mattinmir/fyp/interim/main.tex

%----------------------------------------------------------------------------------------
%	PACKAGES AND OTHER DOCUMENT CONFIGURATIONS
%----------------------------------------------------------------------------------------

\documentclass[12pt]{report}
\usepackage[english]{babel}
\usepackage[utf8x]{inputenc}
\usepackage{amsmath}
\usepackage{graphicx}
\usepackage{float}
\usepackage[table,xcdraw]{xcolor}
\usepackage[colorinlistoftodos]{todonotes}
\usepackage{cite}
\usepackage{url}
\usepackage[margin=1in]{geometry}
\usepackage{booktabs}
\usepackage{dirtytalk}

\begin{document}

\begin{titlepage}

\newcommand{\HRule}{\rule{\linewidth}{0.5mm}} % Defines a new command for the horizontal lines, change thickness here

\center % Center everything on the page

%%	HEADING SECTIONS  %%

\textsc{\LARGE Imperial College London}\\[1.5cm] % Name of your university/college

%%	TITLE SECTION  %%

\HRule \\[0.4cm]
{ \huge \bfseries Smart Rods (Hardware) \\ Interim Report}\\[0.4cm] % Title of your document
\HRule \\[1.5cm]

%%	AUTHOR SECTION  %%

\begin{minipage}{0.4\textwidth}
\begin{flushleft} \large
\emph{Author:}\\
Mattin \textsc{Mir-Tahmasebi} % Your name
CID: 00824754
\end{flushleft}
\end{minipage}
~
\begin{minipage}{0.4\textwidth}
\begin{flushright} \large
\emph{Supervisor:} \\
Prof. George \textsc{Constantinides} % Supervisor's Name
\end{flushright}
\end{minipage}\\[2cm]

% If you don't want a supervisor, uncomment the two lines below and remove the section above
%\Large \emph{Author:}\\
%John \textsc{Smith}\\[3cm] % Your name

%%	LOGO SECTION  %%

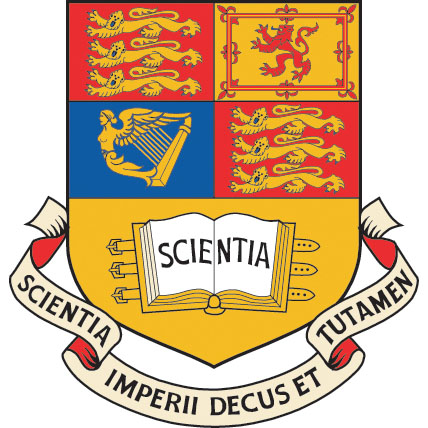
[picture p1: ImperialCrest.jpg]
\\[1cm] % Include a department/university logo - this will require the graphicx package
 
%----------------------------------------------------------------------------------------

\vfill % Fill the rest of the page with whitespace

\end{titlepage}

%% CONTENTS %%

\tableofcontents
\thispagestyle{empty}
\newpage

\pagenumbering{arabic}
\setcounter{page}{1}

%% CHAPTERS %%

\input{sections/project_specification}
\input{sections/background}
\input{sections/design_choices}
\input{sections/implementation_plan}
\input{sections/evaluation_plan}

\bibliography{references}
\bibliographystyle{ieeetr}

\end{document}
