mattinmir/fyp/interim/pics/5r.png

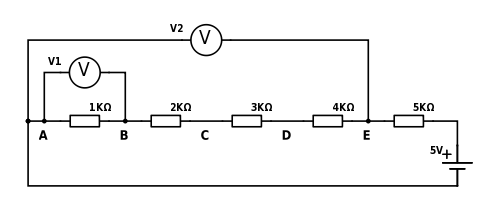
interim/pics/5r.png
