mattinmir/fyp/interim/pics/connectors.JPG

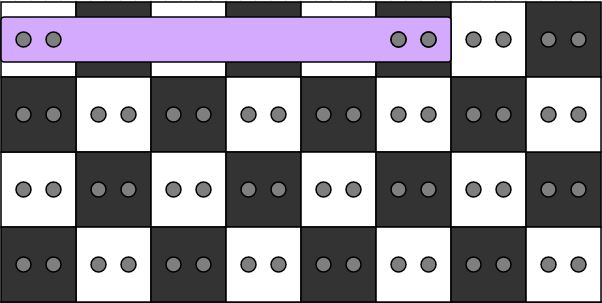
interim/pics/connectors.JPG
