mattinmir/fyp/interim/pics/doubleunitrod.png

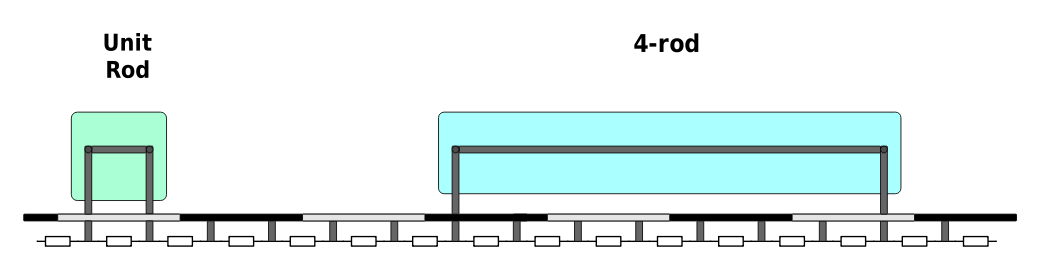
interim/pics/doubleunitrod.png
