mattinmir/fyp/interim/pics/unitrod.png

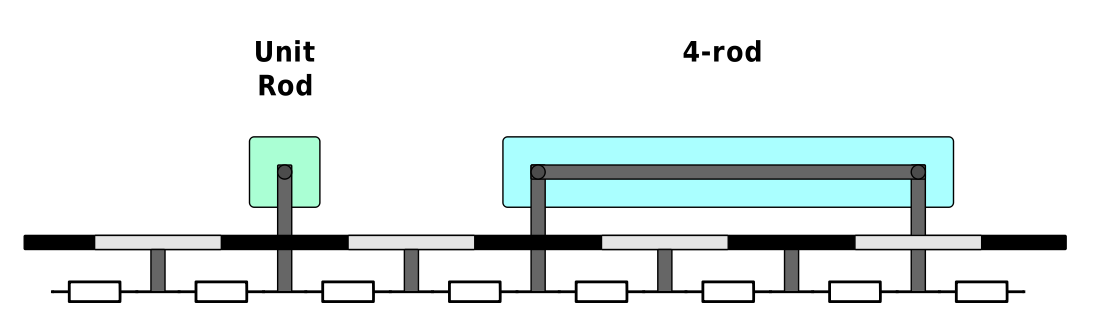
interim/pics/unitrod.png
