mattinmir/fyp/3D Printing/Failed Designs/TenRod_Conductive.stl

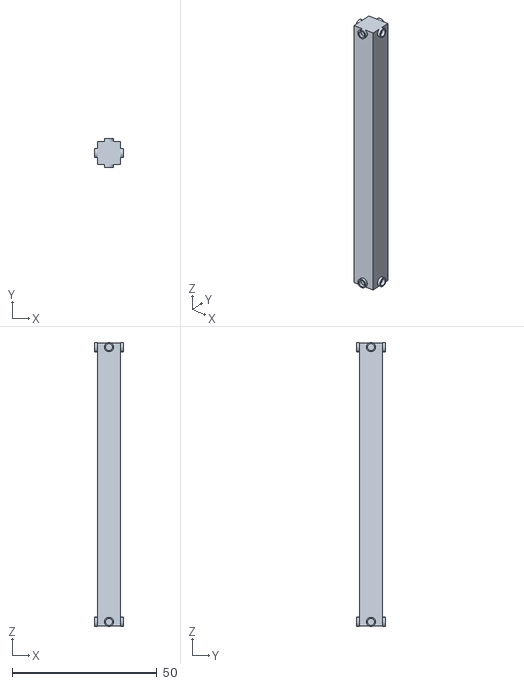
[picture p11: CAD file, 2017-05-26]
3D Printing/Failed Designs/TenRod_Conductive.stl
10.0 x 10.0 x 98.2
