mattinmir/fyp/3D Printing/filled_hole.stl

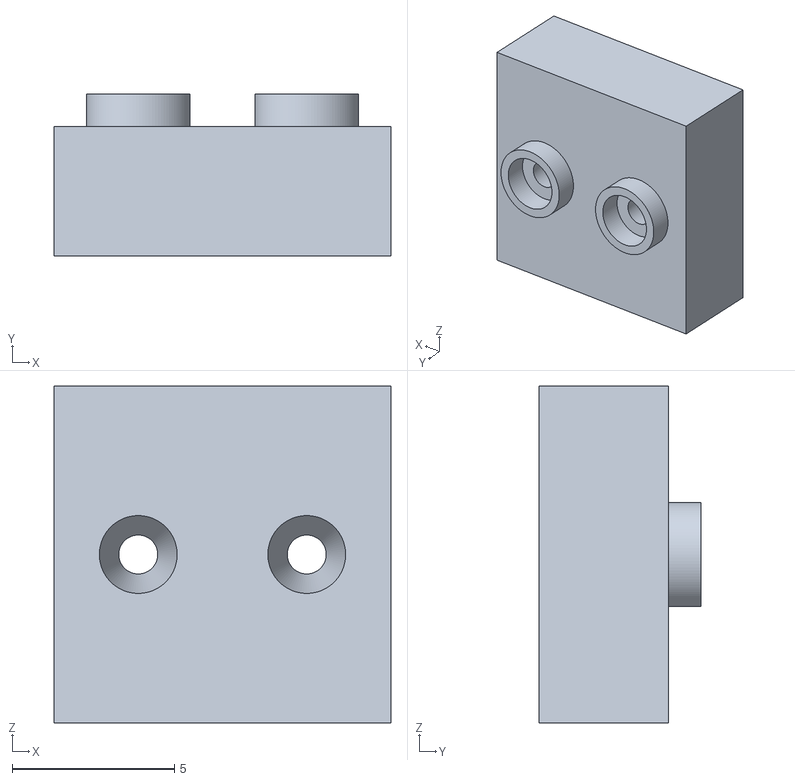
[picture p12: CAD file, 2017-06-14]
3D Printing/filled_hole.stl
10.4 x 5.00 x 10.4
