mattinmir/fyp/3D Printing/header_rods/header_8_rod v2.stl

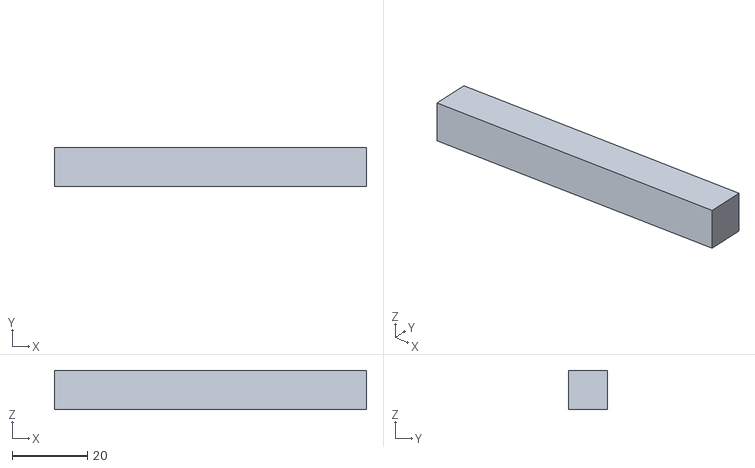
[picture p13: CAD file, 2017-06-18]
3D Printing/header_rods/header_8_rod v2.stl
83.2 x 10.4 x 10.4
