mattinmir/fyp/3D Printing/board_headers_test.stl

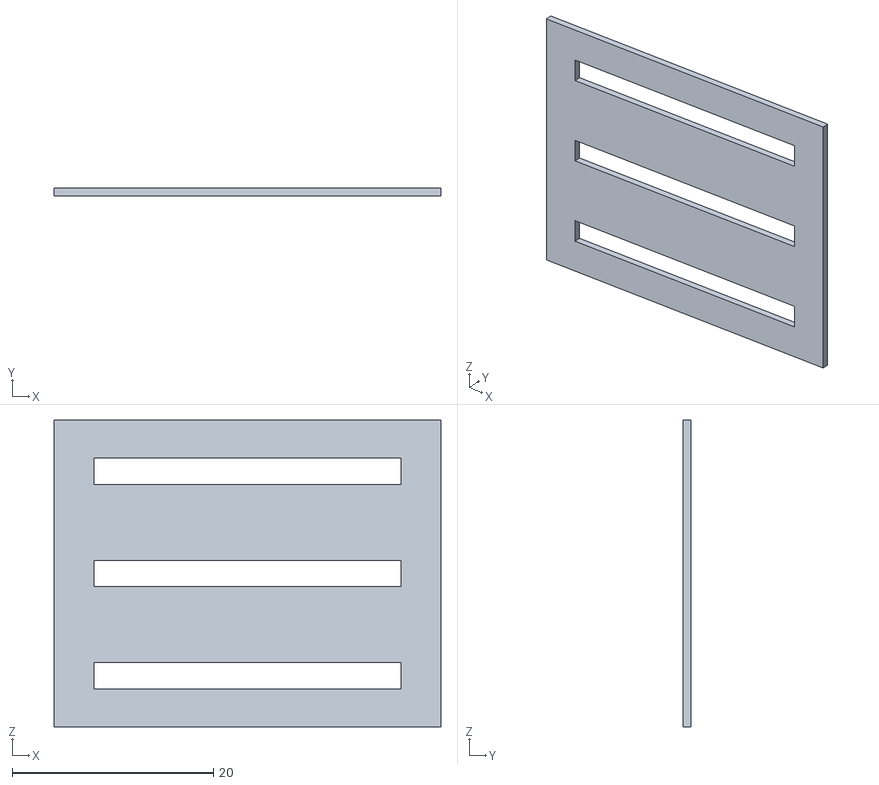
[picture p14: CAD file, 2017-06-13]
3D Printing/board_headers_test.stl
38.5 x 0.8 x 30.5
