mattinmir/fyp/3D Printing/Failed Designs/TenRod_NonConductive.stl

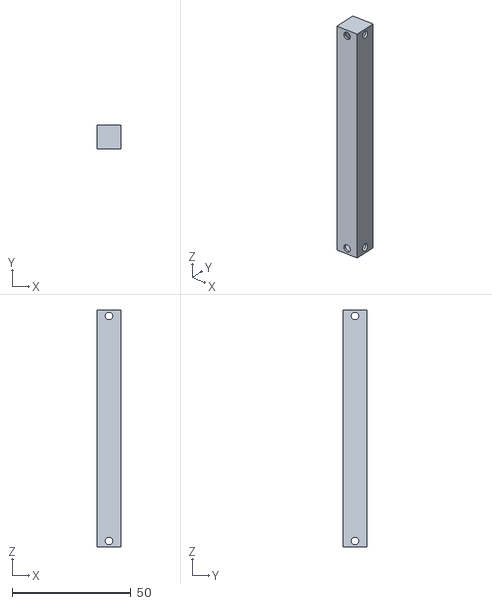
[picture p15: CAD file, 2017-05-26]
3D Printing/Failed Designs/TenRod_NonConductive.stl
10.0 x 10.0 x 100.0
