mattinmir/fyp/3D Printing/header_rods/header_4_rod v2.stl

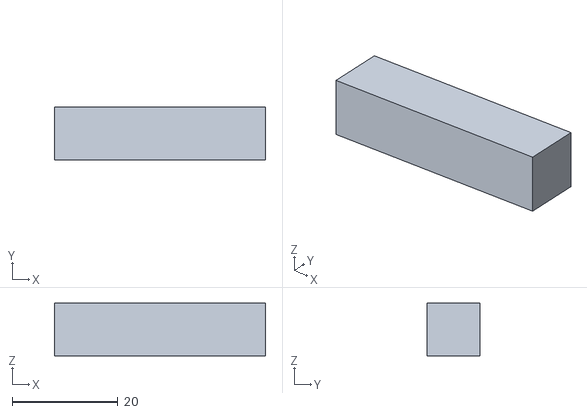
[picture p16: CAD file, 2017-06-18]
3D Printing/header_rods/header_4_rod v2.stl
40.0 x 10.0 x 10.0
