mattinmir/fyp/3D Printing/Board_Lid.stl

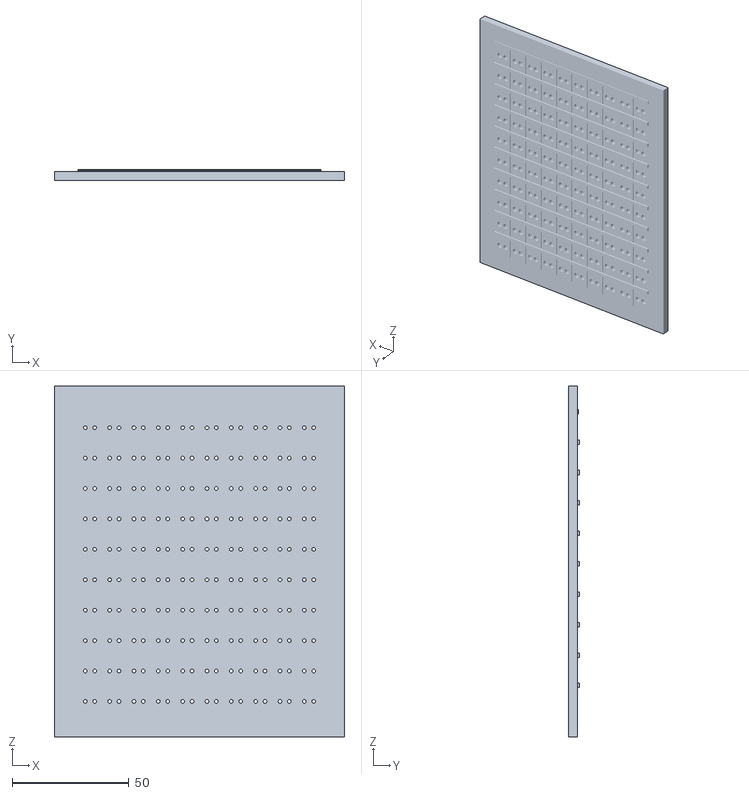
[picture p17: CAD file, 2017-06-13]
3D Printing/Board_Lid.stl
124.0 x 4.80 x 150.0
