mattinmir/fyp/3D Printing/Failed Designs/UnitRod_Conductive.stl

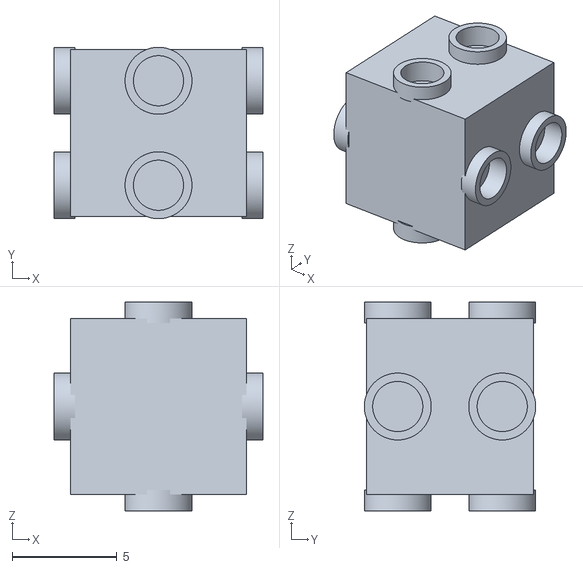
[picture p18: CAD file, 2017-05-26]
3D Printing/Failed Designs/UnitRod_Conductive.stl
10.0 x 8.20 x 10.0
