mattinmir/fyp/3D Printing/header_rods/header_6_rod v2.stl

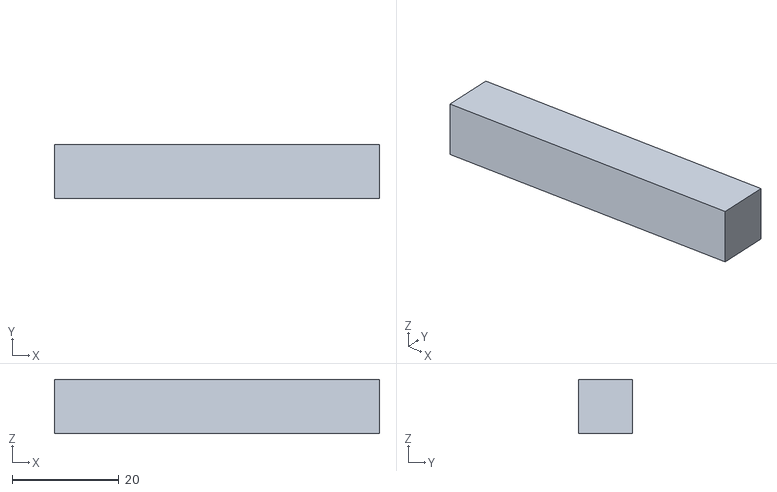
[picture p19: CAD file, 2017-06-18]
3D Printing/header_rods/header_6_rod v2.stl
61.0 x 10.2 x 10.2
