mattinmir/fyp/3D Printing/Failed Designs/UnitRod_NonConductive.stl

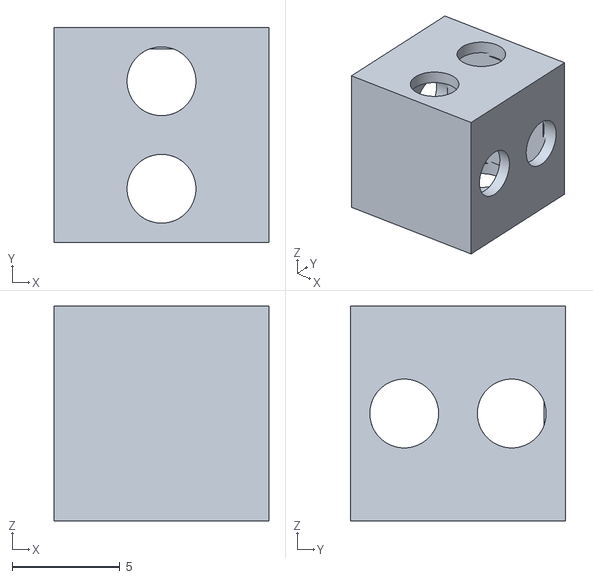
[picture p20: CAD file, 2017-05-23]
3D Printing/Failed Designs/UnitRod_NonConductive.stl
10.0 x 10.0 x 10.0
