mattinmir/fyp/3D Printing/header_rods/header_2_rod v2.stl

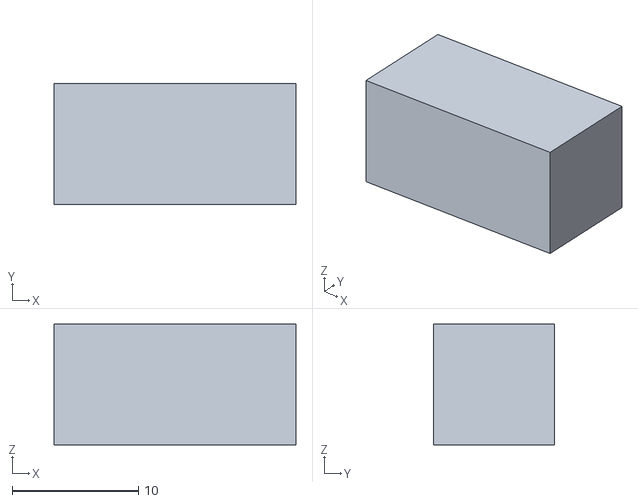
[picture p21: CAD file, 2017-06-18]
3D Printing/header_rods/header_2_rod v2.stl
19.2 x 9.60 x 9.60
