mattinmir/fyp/3D Printing/split_rod_header.stl

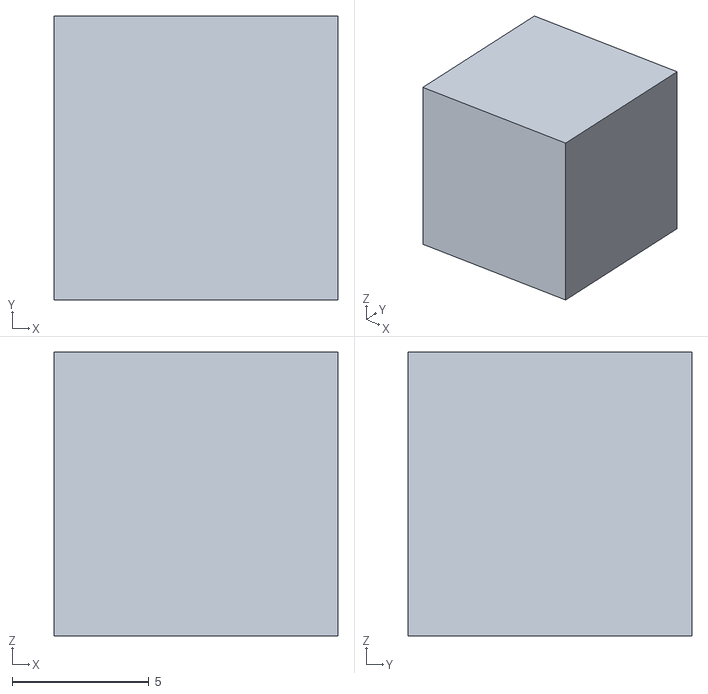
[picture p22: CAD file, 2017-06-13]
3D Printing/split_rod_header.stl
10.4 x 10.4 x 10.4
