mattinmir/fyp/3D Printing/board_lid_test.stl

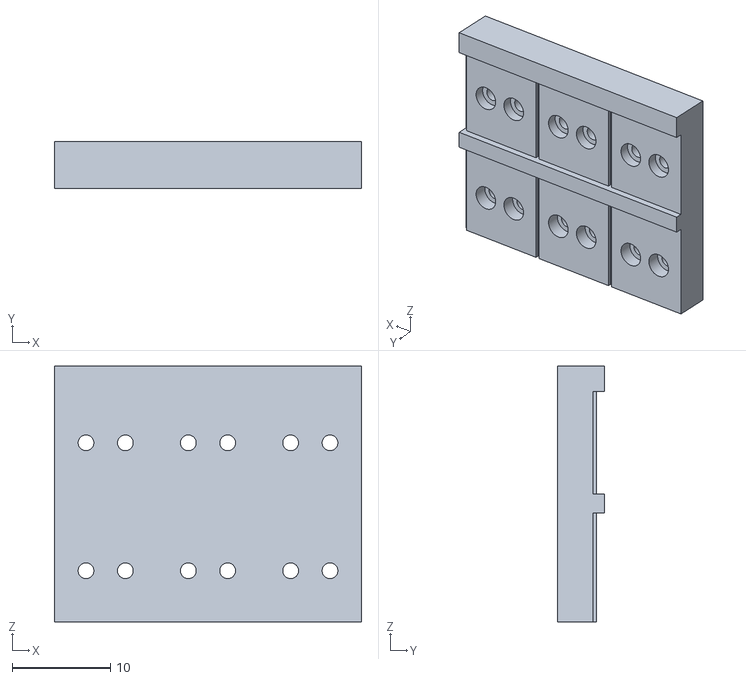
[picture p23: CAD file, 2017-06-12]
3D Printing/board_lid_test.stl
31.2 x 4.80 x 26.0
