mattinmir/fyp/3D Printing/Failed Designs/UnitRod_outer.stl

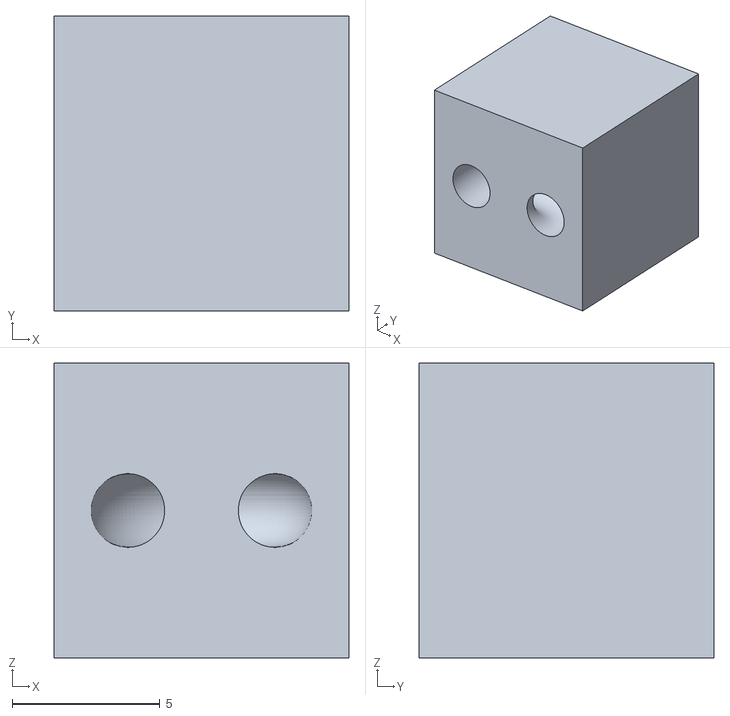
[picture p24: CAD file, 2017-05-19]
3D Printing/Failed Designs/UnitRod_outer.stl
10.0 x 10.0 x 10.0
