mattinmir/fyp/3D Printing/header_rods/header_rod v5.stl

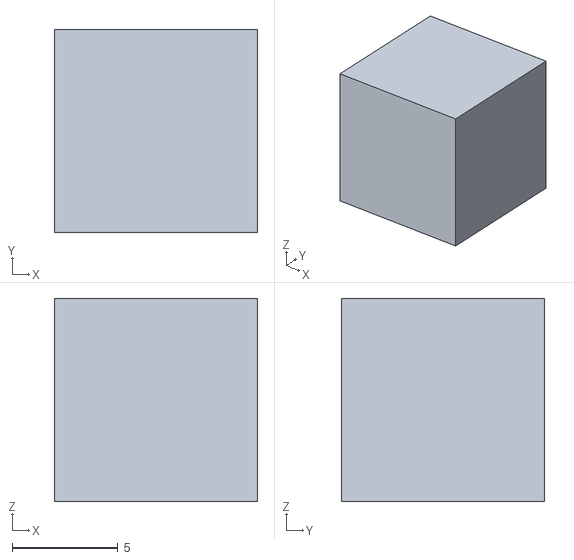
[picture p25: CAD file, 2017-06-18]
3D Printing/header_rods/header_rod v5.stl
9.60 x 9.60 x 9.60
