mattinmir/fyp/3D Printing/Failed Designs/UnitRod_inner.stl

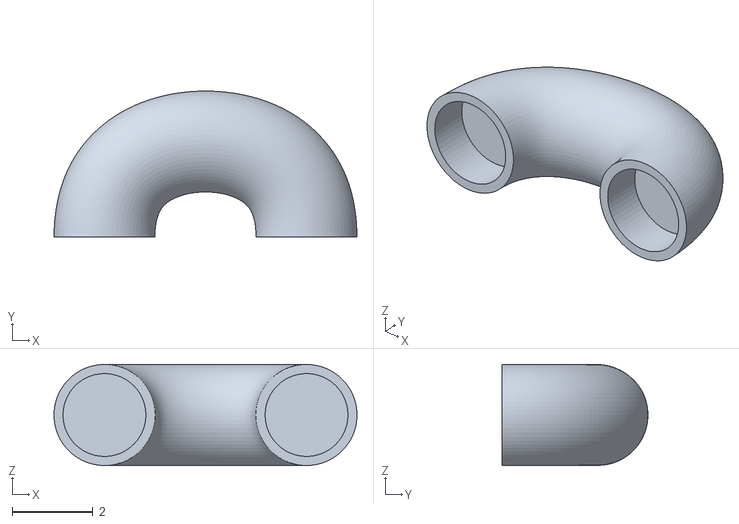
[picture p26: CAD file, 2017-05-19]
3D Printing/Failed Designs/UnitRod_inner.stl
7.50 x 3.61 x 2.50
