mattinmir/fyp/3D Printing/header_rods/header_5_rod v2.stl

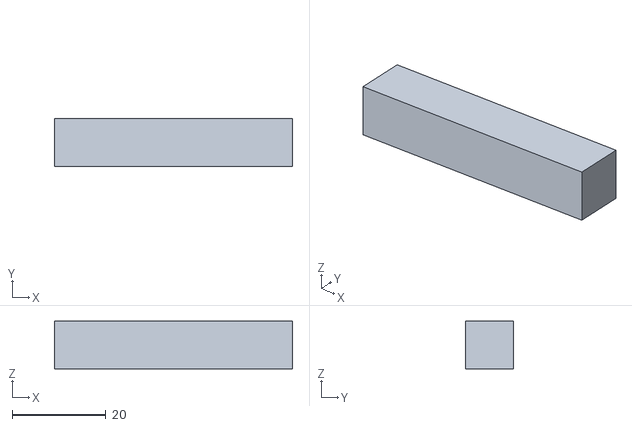
[picture p27: CAD file, 2017-06-18]
3D Printing/header_rods/header_5_rod v2.stl
50.8 x 10.2 x 10.2
