mattinmir/fyp/3D Printing/Split_Rod.stl

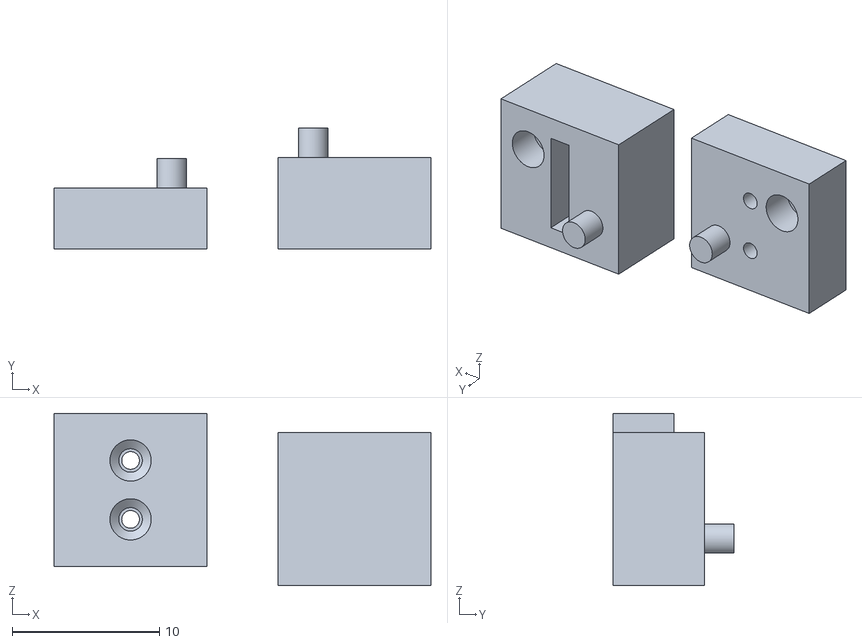
[picture p28: CAD file, 2017-06-11]
3D Printing/Split_Rod.stl
25.6 x 8.24 x 11.7
