mattinmir/fyp/3D Printing/Board_Base.stl

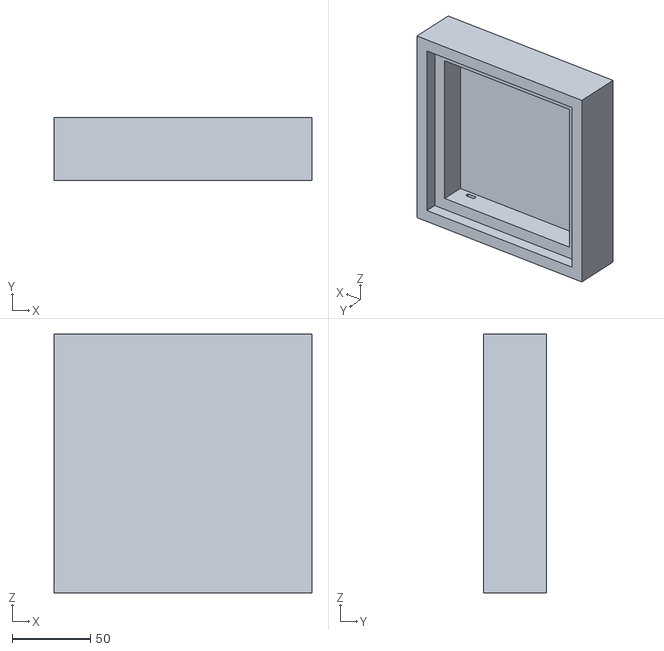
[picture p29: CAD file, 2017-05-28]
3D Printing/Board_Base.stl
165.0 x 40.0 x 165.4
