mattinmir/fyp/3D Printing/Failed Designs/Test_Rods.stl

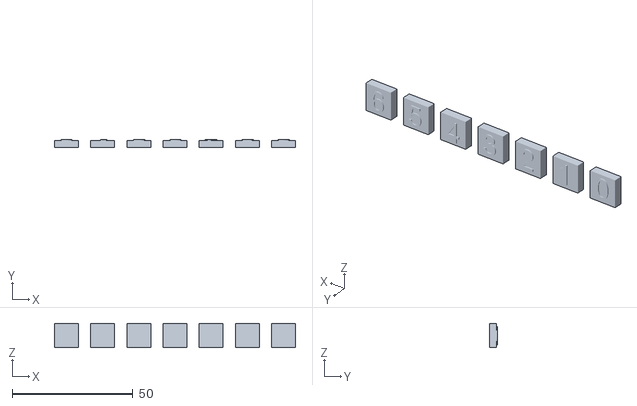
[picture p30: CAD file, 2017-05-19]
3D Printing/Failed Designs/Test_Rods.stl
100.0 x 3.50 x 10.0
