mattinmir/fyp/3D Printing/header_rods/header_3_rod v2.stl

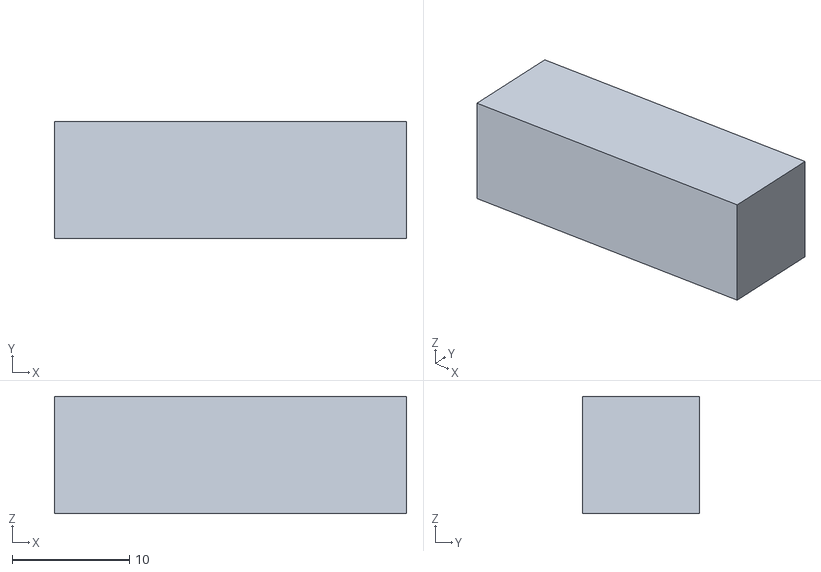
[picture p31: CAD file, 2017-06-18]
3D Printing/header_rods/header_3_rod v2.stl
30.0 x 10.0 x 10.0
