mattinmir/fyp/3D Printing/header_rods/header_7_rod v2.stl

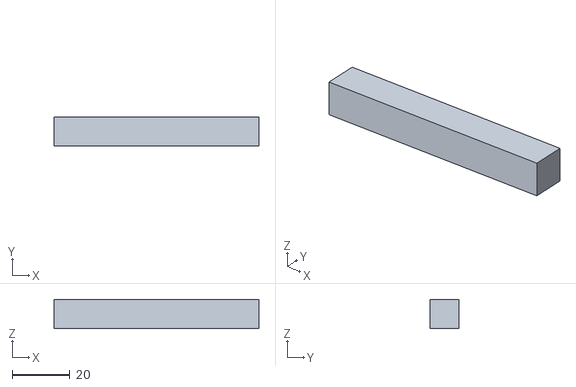
[picture p32: CAD file, 2017-06-18]
3D Printing/header_rods/header_7_rod v2.stl
71.1 x 10.2 x 10.2
