mattinmir/fyp/3D Printing/header_rods/header_9_rod v2.stl

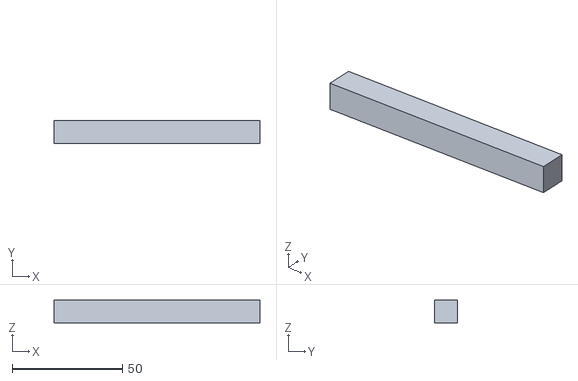
[picture p33: CAD file, 2017-06-15]
3D Printing/header_rods/header_9_rod v2.stl
93.6 x 10.4 x 10.4
