mattinmir/fyp/3D Printing/header_rods/header_10_rod v2.stl

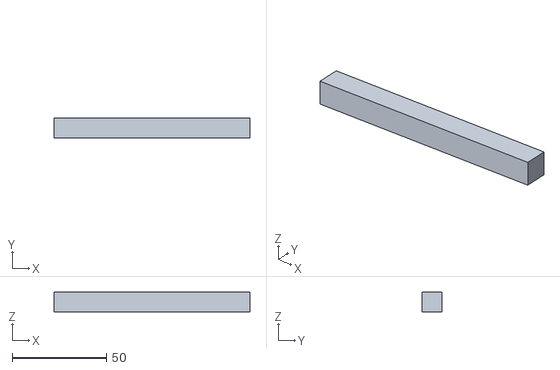
[picture p34: CAD file, 2017-06-15]
3D Printing/header_rods/header_10_rod v2.stl
104.0 x 10.4 x 10.4
