mattinmir/fyp/3D Printing/pics/board_case.png

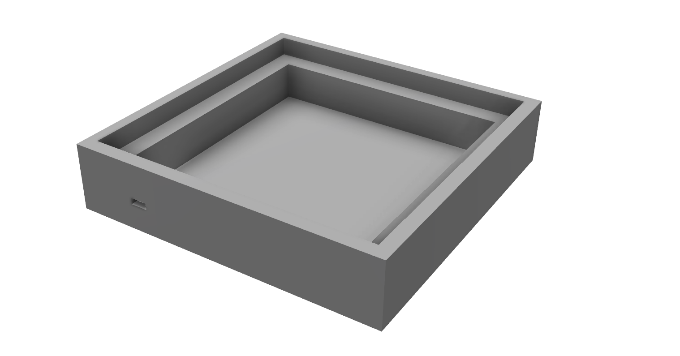
3D Printing/pics/board_case.png
