mattinmir/fyp/3D Printing/pics/boardlid.png

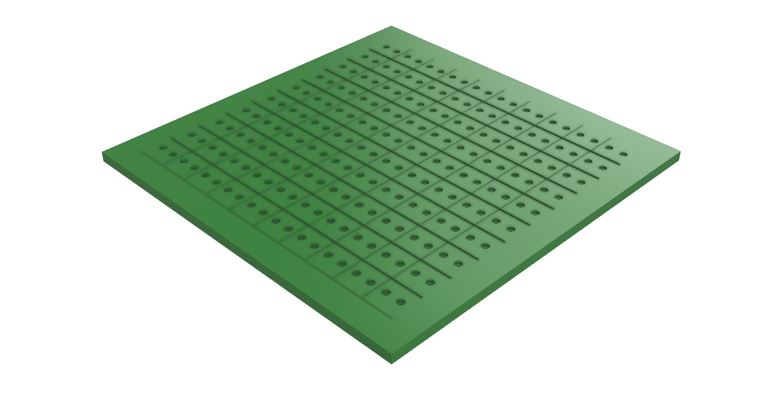
3D Printing/pics/boardlid.png
