mattinmir/fyp/3D Printing/pics/boardlid_nolines.png

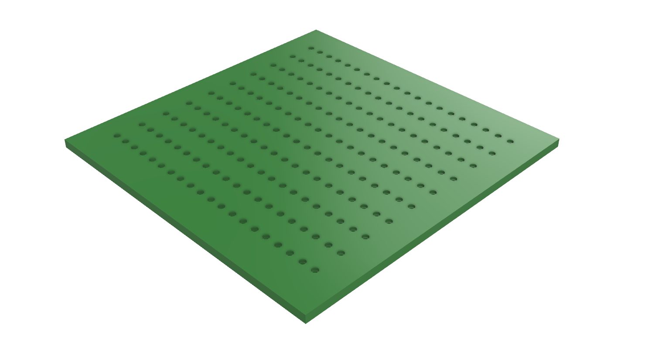
3D Printing/pics/boardlid_nolines.png
