mattinmir/fyp/3D Printing/pics/header_rod.png

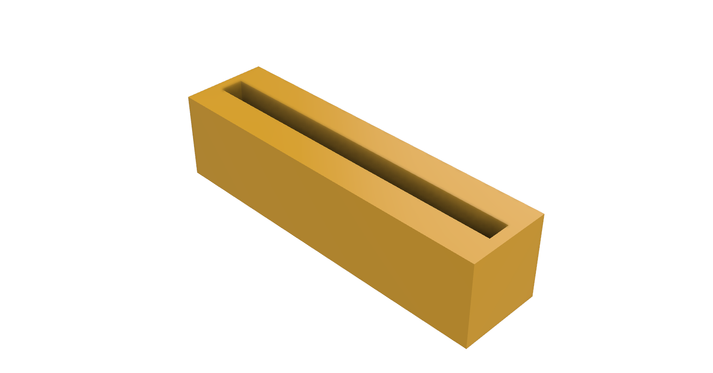
3D Printing/pics/header_rod.png
