mattinmir/fyp/3D Printing/pics/rod_cross_section_filled.png

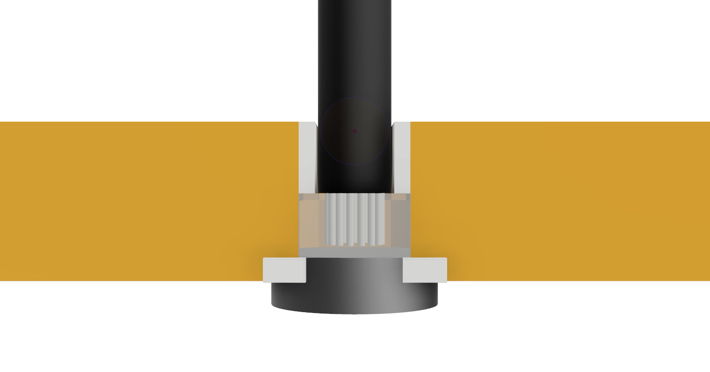
3D Printing/pics/rod_cross_section_filled.png
