mattinmir/fyp/3D Printing/pics/rod_cross_section_nofill.png

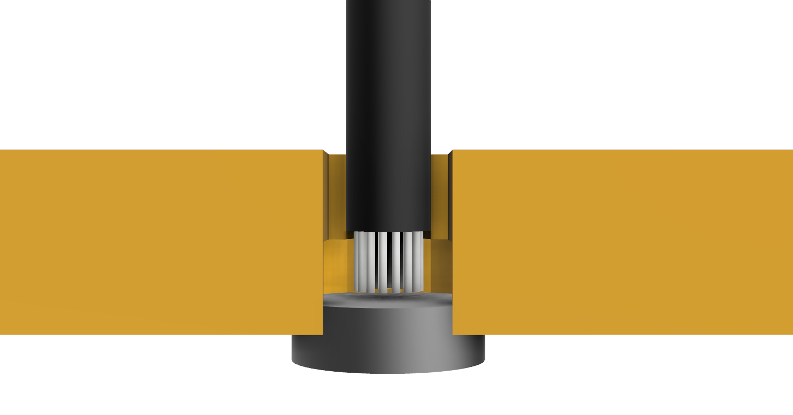
3D Printing/pics/rod_cross_section_nofill.png
