mattinmir/fyp/3D Printing/pics/splitrod_viewbottomhome.png

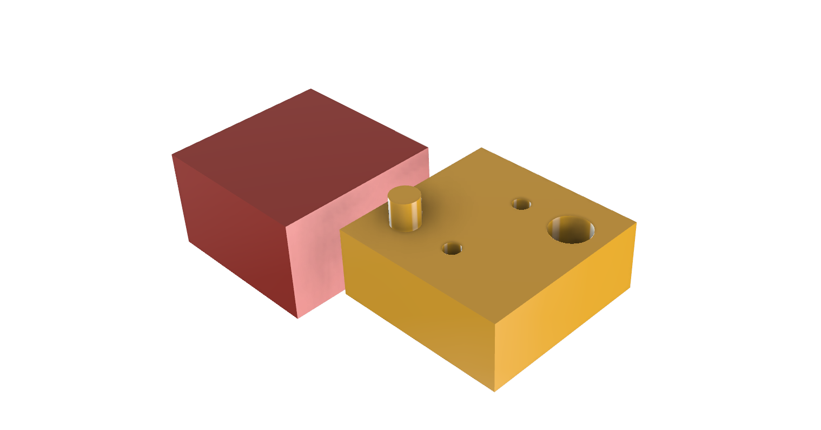
3D Printing/pics/splitrod_viewbottomhome.png
