mattinmir/fyp/3D Printing/pics/splitrod_viewhome.png

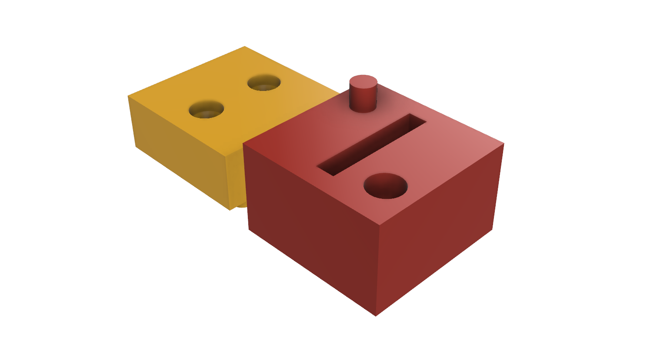
3D Printing/pics/splitrod_viewhome.png
