mattinmir/fyp/3D Printing/pics/splitrod_viewtop.png

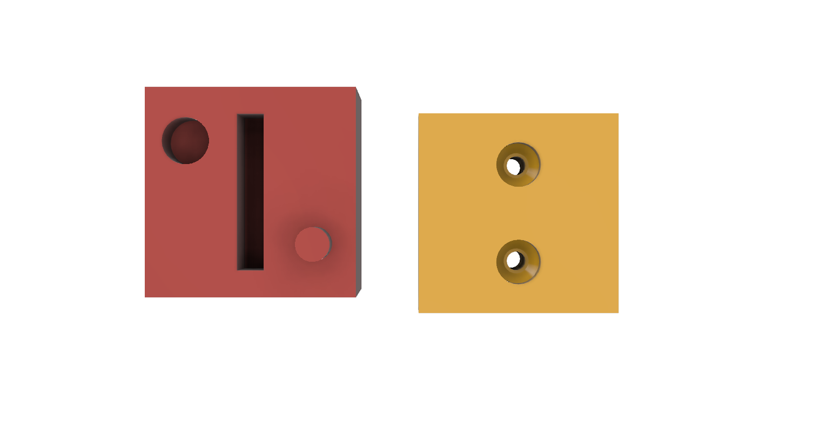
3D Printing/pics/splitrod_viewtop.png
