mattinmir/fyp/3D Printing/pics/tenrod_render.png

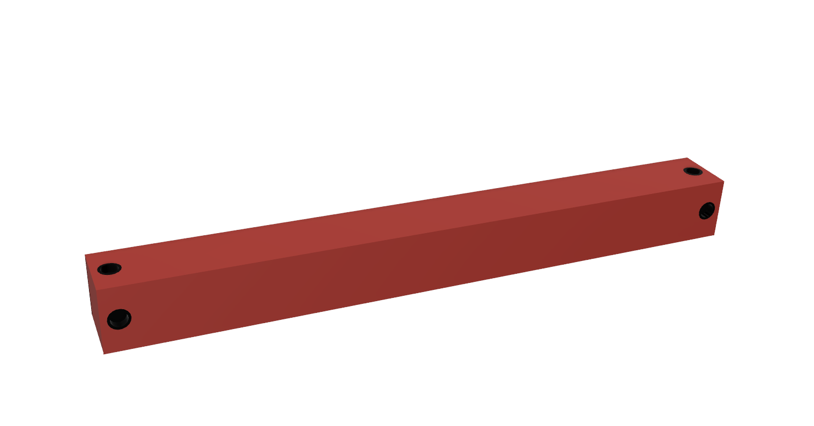
3D Printing/pics/tenrod_render.png
