mattinmir/fyp/(list of files, drawings)

Other design files:
Circuit Diagrams/Fritzing/final.fzz
Circuit Diagrams/Fritzing/stripboard.fzz
