mattinmir/fyp/Circuit Diagrams/eagle/fyp.sch

## EAGLE design Circuit Diagrams/eagle/fyp.sch (2017-05-13)

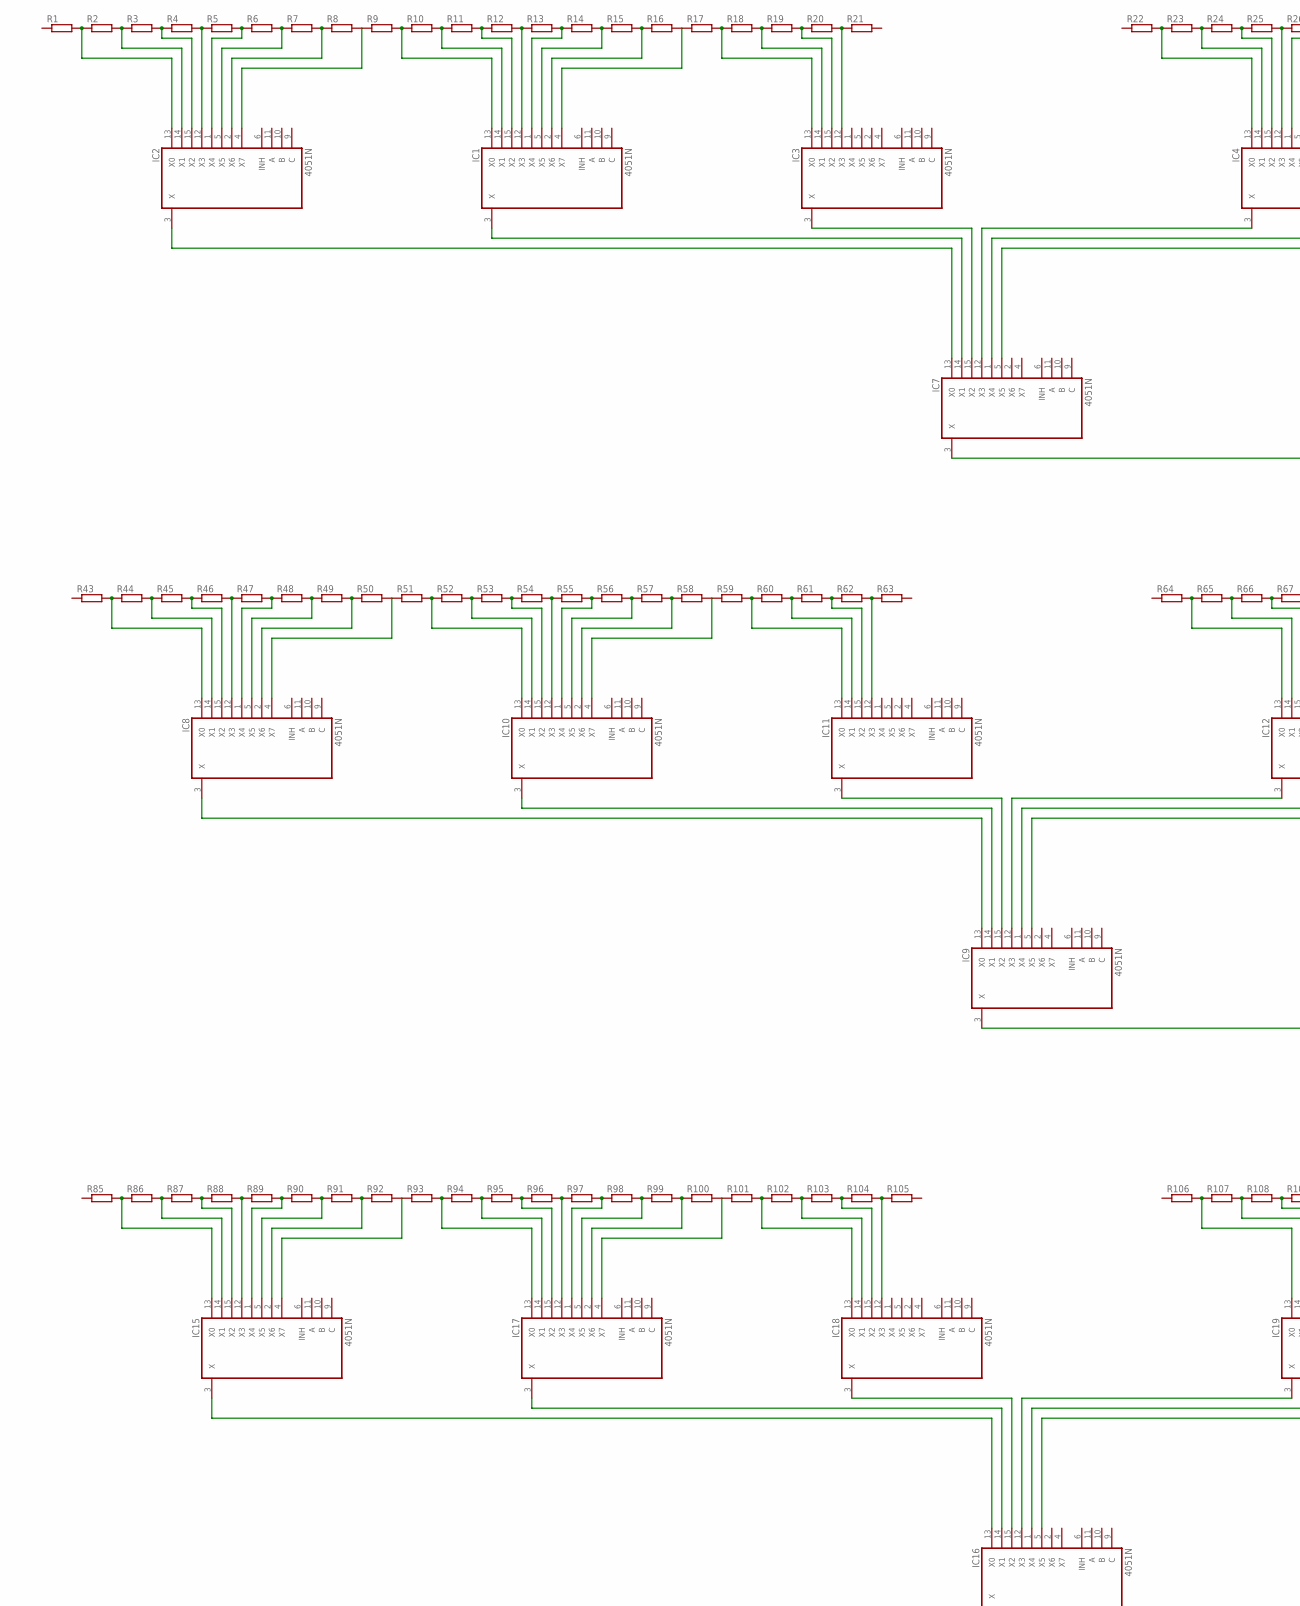
[picture p45: schematic fyp.sch, part in row 1, column 1]

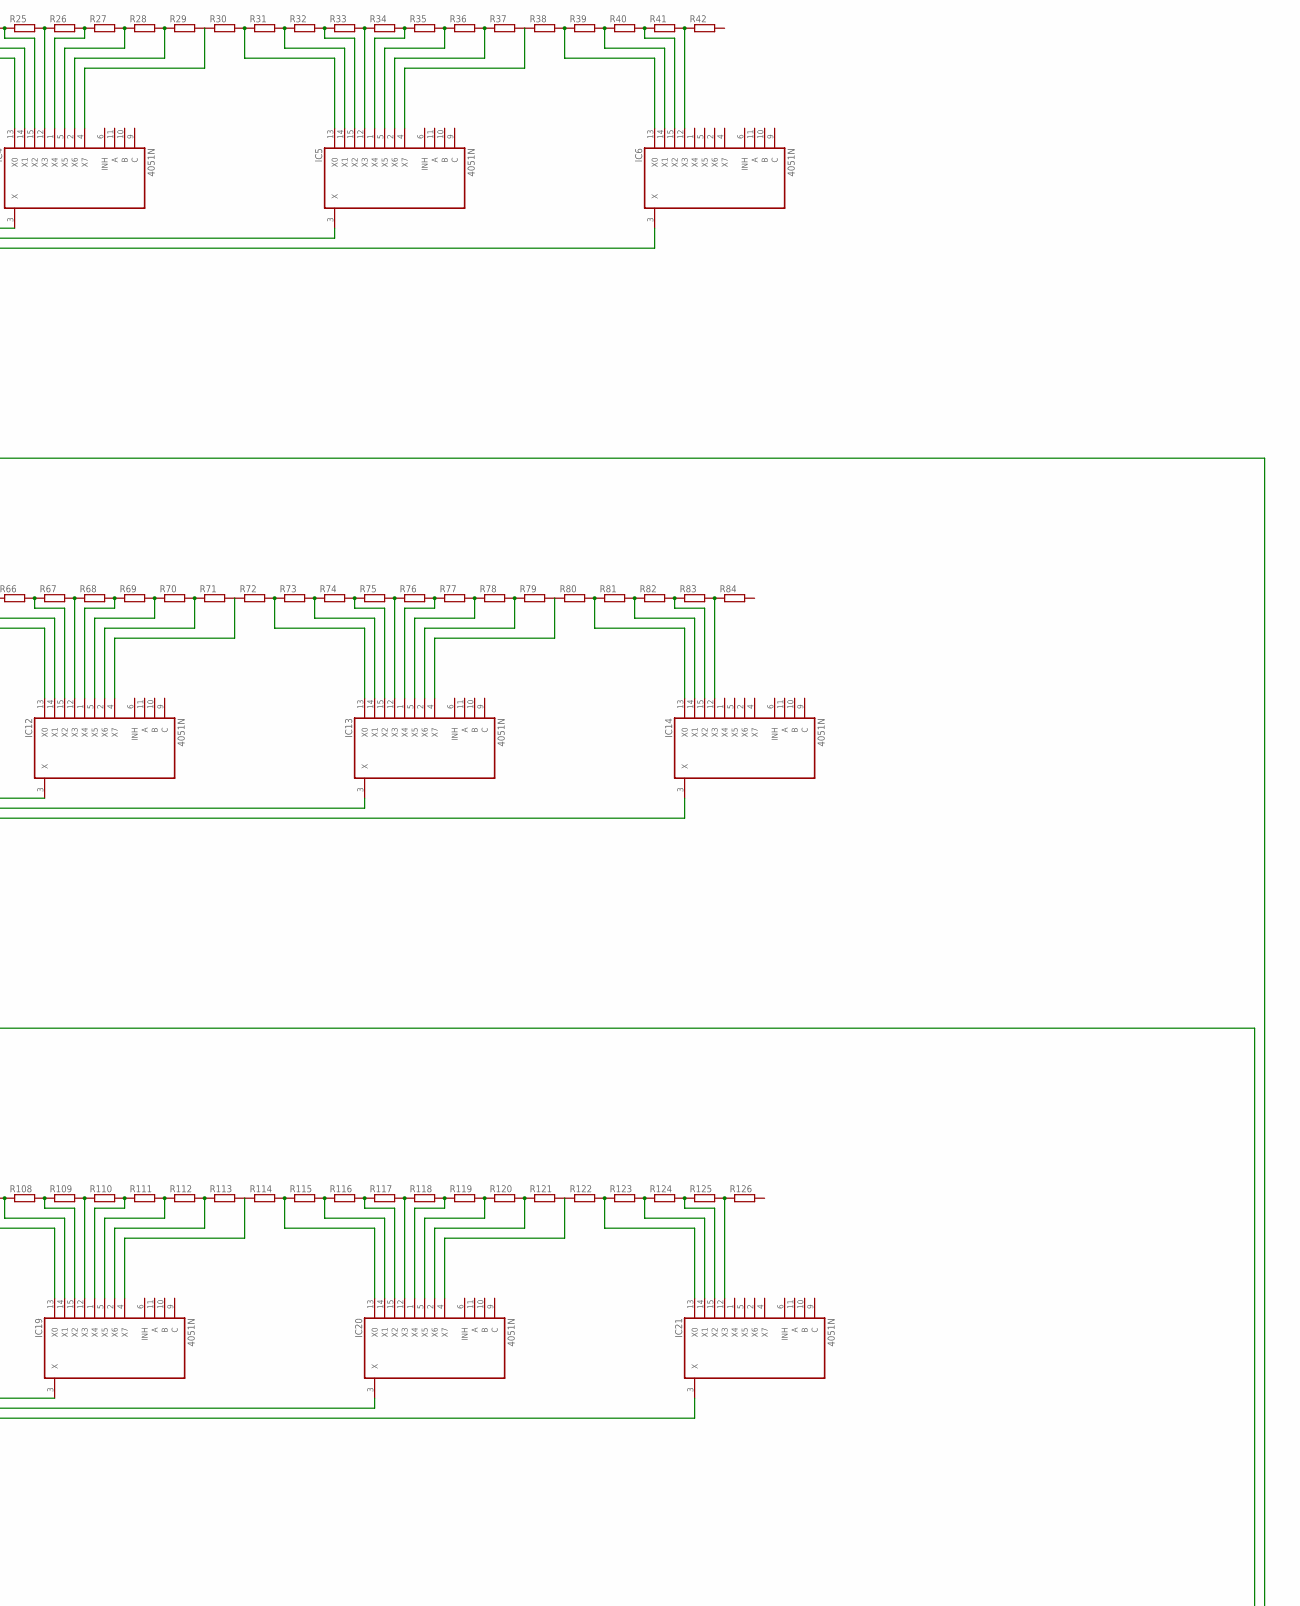
[picture p46: schematic fyp.sch, part in row 1, column 2]

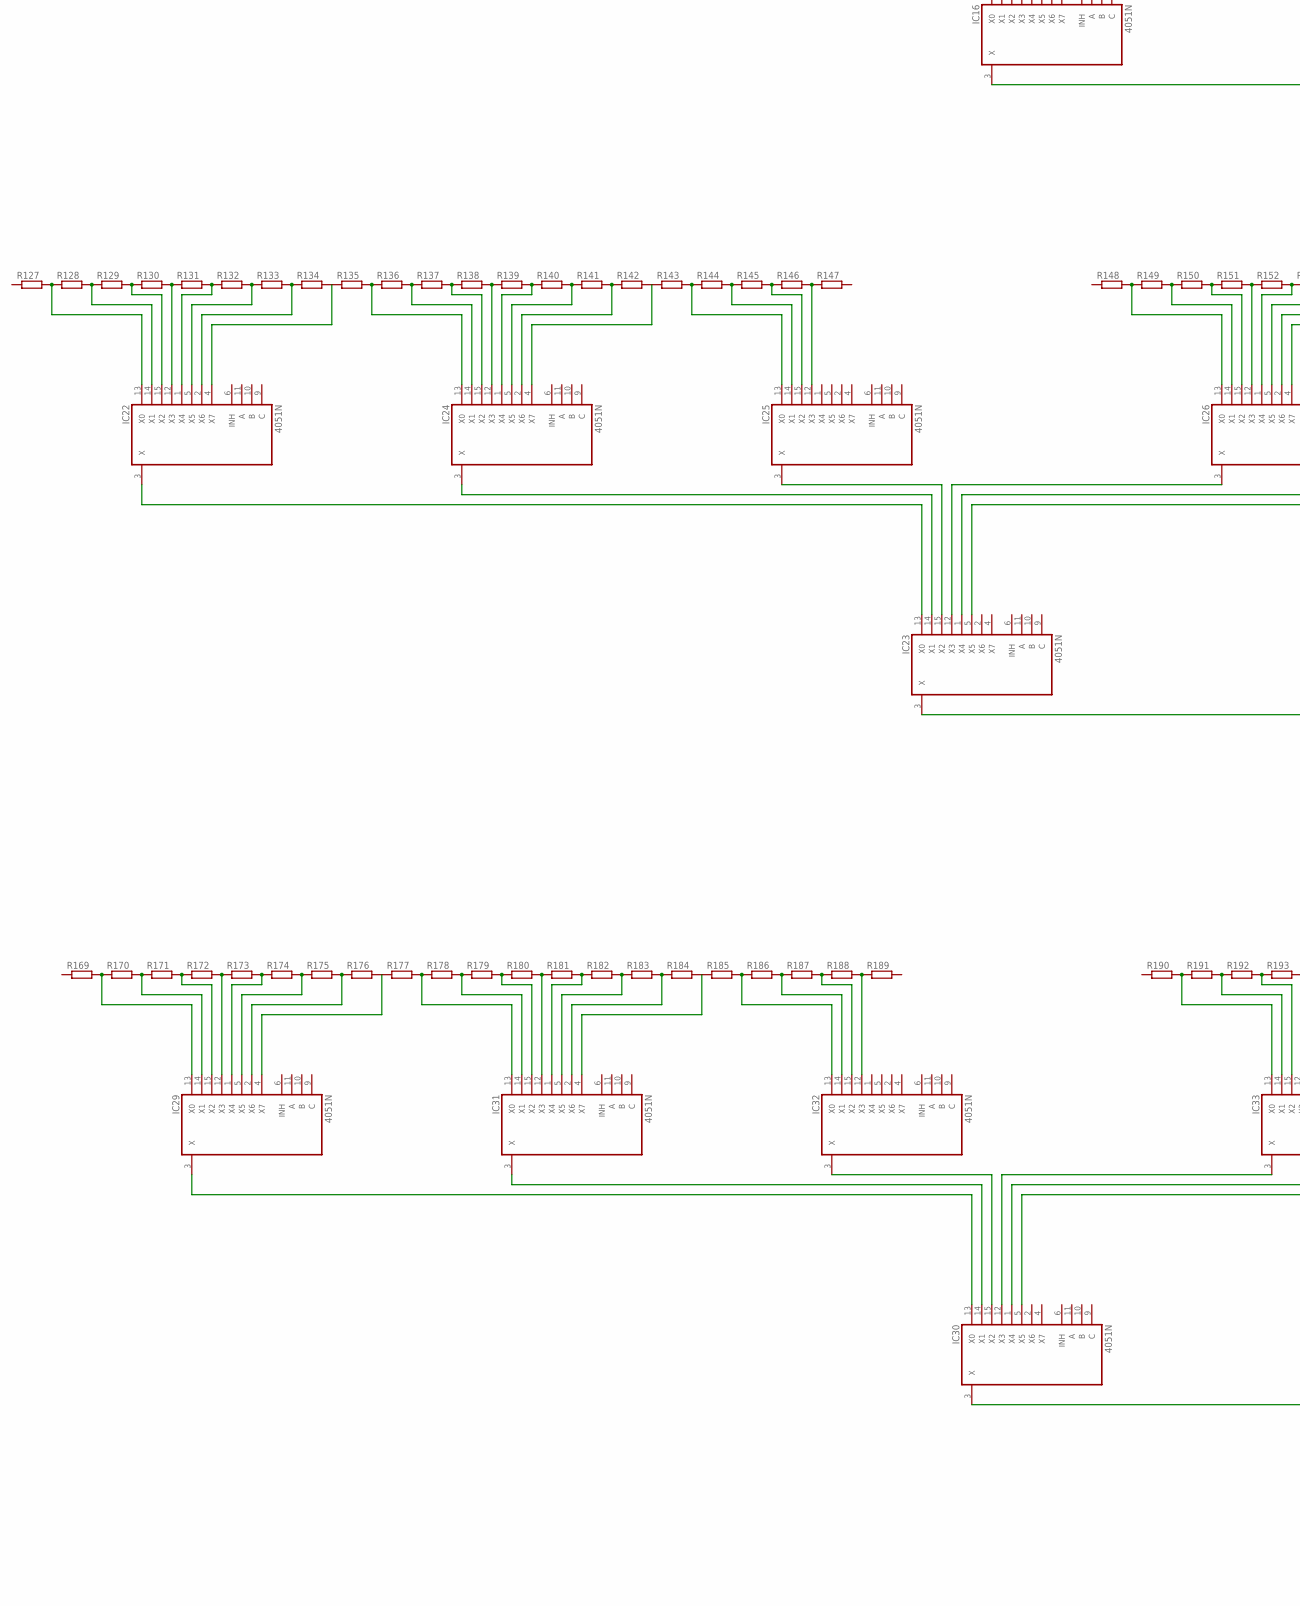
[picture p47: schematic fyp.sch, part in row 2, column 1]

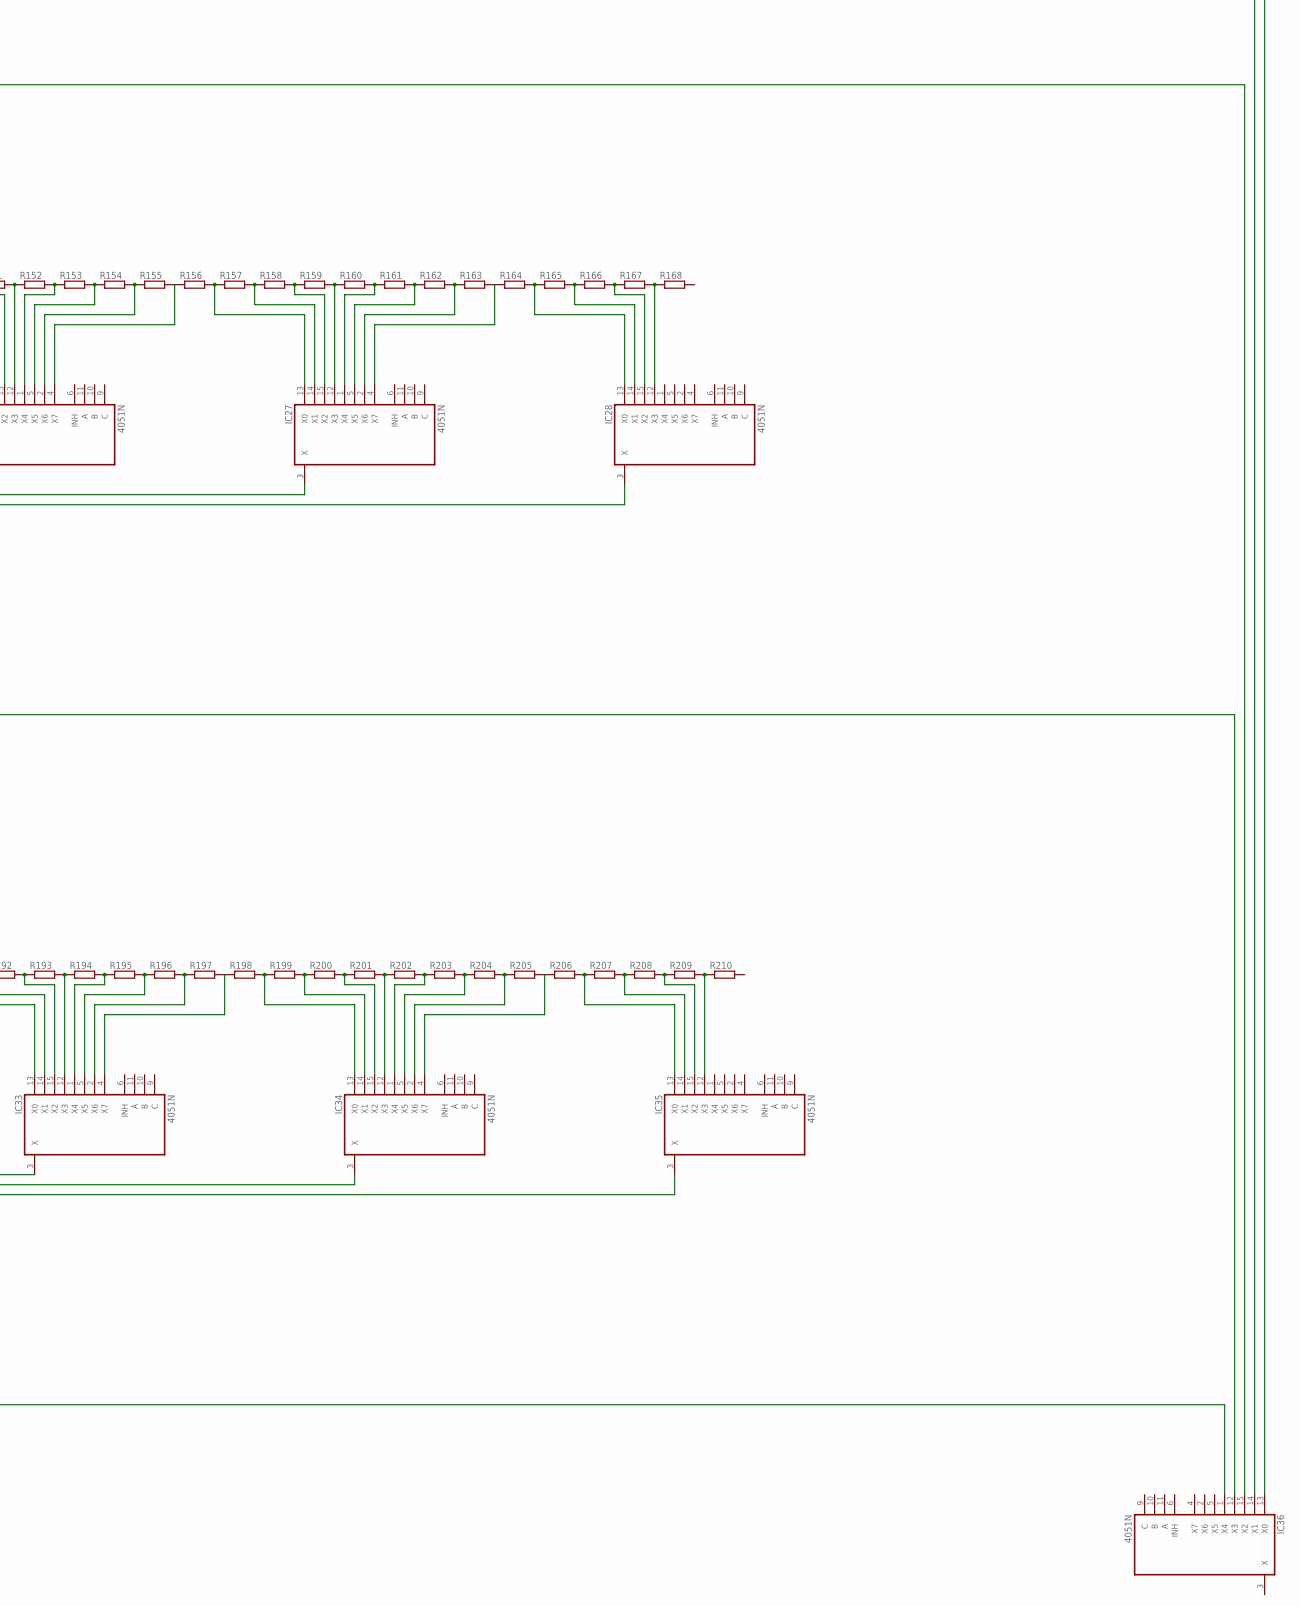
[picture p48: schematic fyp.sch, part in row 2, column 2]

Parts:
IC1, IC2, IC3, IC4, IC5, IC6, IC7, IC8, IC9, IC10, IC11, IC12, IC13, IC14, IC15, IC16, IC17, IC18, IC19, IC20, IC21, IC22, IC23, IC24, IC25, IC26, IC27, IC28, IC29, IC30, IC31, IC32, IC33, IC34, IC35, IC36: 4051N; DIL16
R1, R2, R3, R4, R5, R6, R7, R8, R9, R10, R11, R12, R13, R14, R15, R16, R17, R18, R19, R20, R21, R22, R23, R24, R25, R26, R27, R28, R29, R30, R31, R32, R33, R34, R35, R36, R37, R38, R39, R40, R41, R42, R43, R44, R45, R46, R47, R48, R49, R50, R51, R52, R53, R54, R55, R56, R57, R58, R59, R60, R61, R62, R63, R64, R65, R66, R67, R68, R69, R70, R71, R72, R73, R74, R75, R76, R77, R78, R79, R80, R81, R82, R83, R84, R85, R86, R87, R88, R89, R90, R91, R92, R93, R94, R95, R96, R97, R98, R99, R100, R101, R102, R103, R104, R105, R106, R107, R108, R109, R110, R111, R112, R113, R114, R115, R116, R117, R118, R119, R120, R121, R122, R123, R124, R125, R126, R127, R128, R129, R130, R131, R132, R133, R134, R135, R136, R137, R138, R139, R140, R141, R142, R143, R144, R145, R146, R147, R148, R149, R150, R151, R152, R153, R154, R155, R156, R157, R158, R159, R160, R161, R162, R163, R164, R165, R166, R167, R168, R169, R170, R171, R172, R173, R174, R175, R176, R177, R178, R179, R180, R181, R182, R183, R184, R185, R186, R187, R188, R189, R190, R191, R192, R193, R194, R195, R196, R197, R198, R199, R200, R201, R202, R203, R204, R205, R206, R207, R208, R209, R210: R-EU_0204/2V; 0204V

Connections:
unnamed: IC2.13 (X0), R1.2, R2.1
unnamed: IC2.14 (X1), R2.2, R3.1
unnamed: IC2.15 (X2), R3.2, R4.1
unnamed: IC2.12 (X3), R4.2, R5.1
unnamed: IC2.1 (X4), R5.2, R6.1
unnamed: IC2.5 (X5), R6.2, R7.1
unnamed: IC2.2 (X6), R7.2, R8.1
unnamed: IC2.4 (X7), R8.2
unnamed: IC1.13 (X0), R9.2, R10.1
unnamed: IC1.14 (X1), R10.2, R11.1
unnamed: IC1.15 (X2), R11.2, R12.1
unnamed: IC1.12 (X3), R12.2, R13.1
unnamed: IC1.1 (X4), R13.2, R14.1
unnamed: IC1.5 (X5), R14.2, R15.1
unnamed: IC1.2 (X6), R15.2, R16.1
unnamed: IC1.4 (X7), R16.2
unnamed: IC3.13 (X0), R17.2, R18.1
unnamed: IC3.14 (X1), R18.2, R19.1
unnamed: IC3.15 (X2), R19.2, R20.1
unnamed: IC4.13 (X0), R22.2, R23.1
unnamed: IC4.14 (X1), R23.2, R24.1
unnamed: IC4.15 (X2), R24.2, R25.1
unnamed: IC4.12 (X3), R25.2, R26.1
unnamed: IC4.1 (X4), R26.2, R27.1
unnamed: IC4.5 (X5), R27.2, R28.1
unnamed: IC4.2 (X6), R28.2, R29.1
unnamed: IC4.4 (X7), R29.2
unnamed: IC5.13 (X0), R30.2, R31.1
unnamed: IC5.14 (X1), R31.2, R32.1
unnamed: IC5.15 (X2), R32.2, R33.1
unnamed: IC5.12 (X3), R33.2, R34.1
unnamed: IC5.1 (X4), R34.2, R35.1
unnamed: IC5.5 (X5), R35.2, R36.1
unnamed: IC5.2 (X6), R36.2, R37.1
unnamed: IC5.4 (X7), R37.2
unnamed: IC6.13 (X0), R38.2, R39.1
unnamed: IC6.14 (X1), R39.2, R40.1
unnamed: IC6.15 (X2), R40.2, R41.1
unnamed: IC3.12 (X3), R20.2, R21.1
unnamed: IC6.12 (X3), R41.2, R42.1
unnamed: IC3.3 (X), IC7.15 (X2)
unnamed: IC1.3 (X), IC7.14 (X1)
unnamed: IC2.3 (X), IC7.13 (X0)
unnamed: IC4.3 (X), IC7.12 (X3)
unnamed: IC5.3 (X), IC7.1 (X4)
unnamed: IC6.3 (X), IC7.5 (X5)
unnamed: IC8.13 (X0), R43.2, R44.1
unnamed: IC8.14 (X1), R44.2, R45.1
unnamed: IC8.15 (X2), R45.2, R46.1
unnamed: IC8.12 (X3), R46.2, R47.1
unnamed: IC8.1 (X4), R47.2, R48.1
unnamed: IC8.5 (X5), R48.2, R49.1
unnamed: IC8.2 (X6), R49.2, R50.1
unnamed: IC8.4 (X7), R50.2
unnamed: IC10.13 (X0), R51.2, R52.1
unnamed: IC10.14 (X1), R52.2, R53.1
unnamed: IC10.15 (X2), R53.2, R54.1
unnamed: IC10.12 (X3), R54.2, R55.1
unnamed: IC10.1 (X4), R55.2, R56.1
unnamed: IC10.5 (X5), R56.2, R57.1
unnamed: IC10.2 (X6), R57.2, R58.1
unnamed: IC10.4 (X7), R58.2
unnamed: IC11.13 (X0), R59.2, R60.1
unnamed: IC11.14 (X1), R60.2, R61.1
unnamed: IC11.15 (X2), R61.2, R62.1
unnamed: IC11.12 (X3), R62.2, R63.1
unnamed: IC12.13 (X0), R64.2, R65.1
unnamed: IC12.14 (X1), R65.2, R66.1
unnamed: IC12.15 (X2), R66.2, R67.1
unnamed: IC12.12 (X3), R67.2, R68.1
unnamed: IC12.1 (X4), R68.2, R69.1
unnamed: IC12.5 (X5), R69.2, R70.1
unnamed: IC12.2 (X6), R70.2, R71.1
unnamed: IC12.4 (X7), R71.2
unnamed: IC13.13 (X0), R72.2, R73.1
unnamed: IC13.14 (X1), R73.2, R74.1
unnamed: IC13.15 (X2), R74.2, R75.1
unnamed: IC13.12 (X3), R75.2, R76.1
unnamed: IC13.1 (X4), R76.2, R77.1
unnamed: IC13.5 (X5), R77.2, R78.1
unnamed: IC13.2 (X6), R78.2, R79.1
unnamed: IC13.4 (X7), R79.2
unnamed: IC14.13 (X0), R80.2, R81.1
unnamed: IC14.14 (X1), R81.2, R82.1
unnamed: IC14.15 (X2), R82.2, R83.1
unnamed: IC14.12 (X3), R83.2, R84.1
unnamed: IC9.15 (X2), IC11.3 (X)
unnamed: IC9.14 (X1), IC10.3 (X)
unnamed: IC8.3 (X), IC9.13 (X0)
unnamed: IC9.12 (X3), IC12.3 (X)
unnamed: IC9.1 (X4), IC13.3 (X)
unnamed: IC9.5 (X5), IC14.3 (X)
unnamed: IC15.13 (X0), R85.2, R86.1
unnamed: IC15.14 (X1), R86.2, R87.1
unnamed: IC15.15 (X2), R87.2, R88.1
unnamed: IC15.12 (X3), R88.2, R89.1
unnamed: IC15.1 (X4), R89.2, R90.1
unnamed: IC15.5 (X5), R90.2, R91.1
unnamed: IC15.2 (X6), R91.2, R92.1
unnamed: IC15.4 (X7), R92.2
unnamed: IC17.13 (X0), R93.2, R94.1
unnamed: IC17.14 (X1), R94.2, R95.1
unnamed: IC17.15 (X2), R95.2, R96.1
unnamed: IC17.12 (X3), R96.2, R97.1
unnamed: IC17.1 (X4), R97.2, R98.1
unnamed: IC17.5 (X5), R98.2, R99.1
unnamed: IC17.2 (X6), R99.2, R100.1
unnamed: IC17.4 (X7), R100.2
unnamed: IC18.13 (X0), R101.2, R102.1
unnamed: IC18.14 (X1), R102.2, R103.1
unnamed: IC18.15 (X2), R103.2, R104.1
unnamed: IC18.12 (X3), R104.2, R105.1
unnamed: IC19.13 (X0), R106.2, R107.1
unnamed: IC19.14 (X1), R107.2, R108.1
unnamed: IC19.15 (X2), R108.2, R109.1
unnamed: IC19.12 (X3), R109.2, R110.1
unnamed: IC19.1 (X4), R110.2, R111.1
unnamed: IC19.5 (X5), R111.2, R112.1
unnamed: IC19.2 (X6), R112.2, R113.1
unnamed: IC19.4 (X7), R113.2
unnamed: IC20.13 (X0), R114.2, R115.1
unnamed: IC20.14 (X1), R115.2, R116.1
unnamed: IC20.15 (X2), R116.2, R117.1
unnamed: IC20.12 (X3), R117.2, R118.1
unnamed: IC20.1 (X4), R118.2, R119.1
unnamed: IC20.5 (X5), R119.2, R120.1
unnamed: IC20.2 (X6), R120.2, R121.1
unnamed: IC20.4 (X7), R121.2
unnamed: IC21.13 (X0), R122.2, R123.1
unnamed: IC21.14 (X1), R123.2, R124.1
unnamed: IC21.15 (X2), R124.2, R125.1
unnamed: IC21.12 (X3), R125.2, R126.1
unnamed: IC16.15 (X2), IC18.3 (X)
unnamed: IC16.14 (X1), IC17.3 (X)
unnamed: IC15.3 (X), IC16.13 (X0)
unnamed: IC16.12 (X3), IC19.3 (X)
unnamed: IC16.1 (X4), IC20.3 (X)
unnamed: IC16.5 (X5), IC21.3 (X)
unnamed: IC22.13 (X0), R127.2, R128.1
unnamed: IC22.14 (X1), R128.2, R129.1
unnamed: IC22.15 (X2), R129.2, R130.1
unnamed: IC22.12 (X3), R130.2, R131.1
unnamed: IC22.1 (X4), R131.2, R132.1
unnamed: IC22.5 (X5), R132.2, R133.1
unnamed: IC22.2 (X6), R133.2, R134.1
unnamed: IC22.4 (X7), R134.2
unnamed: IC24.13 (X0), R135.2, R136.1
unnamed: IC24.14 (X1), R136.2, R137.1
unnamed: IC24.15 (X2), R137.2, R138.1
unnamed: IC24.12 (X3), R138.2, R139.1
unnamed: IC24.1 (X4), R139.2, R140.1
unnamed: IC24.5 (X5), R140.2, R141.1
unnamed: IC24.2 (X6), R141.2, R142.1
unnamed: IC24.4 (X7), R142.2
unnamed: IC25.13 (X0), R143.2, R144.1
unnamed: IC25.14 (X1), R144.2, R145.1
unnamed: IC25.15 (X2), R145.2, R146.1
unnamed: IC25.12 (X3), R146.2, R147.1
unnamed: IC26.13 (X0), R148.2, R149.1
unnamed: IC26.14 (X1), R149.2, R150.1
unnamed: IC26.15 (X2), R150.2, R151.1
unnamed: IC26.12 (X3), R151.2, R152.1
unnamed: IC26.1 (X4), R152.2, R153.1
unnamed: IC26.5 (X5), R153.2, R154.1
unnamed: IC26.2 (X6), R154.2, R155.1
unnamed: IC26.4 (X7), R155.2
unnamed: IC27.13 (X0), R156.2, R157.1
unnamed: IC27.14 (X1), R157.2, R158.1
unnamed: IC27.15 (X2), R158.2, R159.1
unnamed: IC27.12 (X3), R159.2, R160.1
unnamed: IC27.1 (X4), R160.2, R161.1
unnamed: IC27.5 (X5), R161.2, R162.1
unnamed: IC27.2 (X6), R162.2, R163.1
unnamed: IC27.4 (X7), R163.2
unnamed: IC28.13 (X0), R164.2, R165.1
unnamed: IC28.14 (X1), R165.2, R166.1
unnamed: IC28.15 (X2), R166.2, R167.1
unnamed: IC28.12 (X3), R167.2, R168.1
unnamed: IC23.15 (X2), IC25.3 (X)
unnamed: IC23.14 (X1), IC24.3 (X)
unnamed: IC22.3 (X), IC23.13 (X0)
unnamed: IC23.12 (X3), IC26.3 (X)
unnamed: IC23.1 (X4), IC27.3 (X)
unnamed: IC23.5 (X5), IC28.3 (X)
unnamed: IC29.13 (X0), R169.2, R170.1
unnamed: IC29.14 (X1), R170.2, R171.1
unnamed: IC29.15 (X2), R171.2, R172.1
unnamed: IC29.12 (X3), R172.2, R173.1
unnamed: IC29.1 (X4), R173.2, R174.1
unnamed: IC29.5 (X5), R174.2, R175.1
unnamed: IC29.2 (X6), R175.2, R176.1
unnamed: IC29.4 (X7), R176.2
unnamed: IC31.13 (X0), R177.2, R178.1
unnamed: IC31.14 (X1), R178.2, R179.1
unnamed: IC31.15 (X2), R179.2, R180.1
unnamed: IC31.12 (X3), R180.2, R181.1
unnamed: IC31.1 (X4), R181.2, R182.1
unnamed: IC31.5 (X5), R182.2, R183.1
unnamed: IC31.2 (X6), R183.2, R184.1
unnamed: IC31.4 (X7), R184.2
unnamed: IC32.13 (X0), R185.2, R186.1
unnamed: IC32.14 (X1), R186.2, R187.1
unnamed: IC32.15 (X2), R187.2, R188.1
unnamed: IC32.12 (X3), R188.2, R189.1
unnamed: IC33.13 (X0), R190.2, R191.1
unnamed: IC33.14 (X1), R191.2, R192.1
unnamed: IC33.15 (X2), R192.2, R193.1
unnamed: IC33.12 (X3), R193.2, R194.1
unnamed: IC33.1 (X4), R194.2, R195.1
unnamed: IC33.5 (X5), R195.2, R196.1
unnamed: IC33.2 (X6), R196.2, R197.1
unnamed: IC33.4 (X7), R197.2
unnamed: IC34.13 (X0), R198.2, R199.1
unnamed: IC34.14 (X1), R199.2, R200.1
unnamed: IC34.15 (X2), R200.2, R201.1
unnamed: IC34.12 (X3), R201.2, R202.1
unnamed: IC34.1 (X4), R202.2, R203.1
unnamed: IC34.5 (X5), R203.2, R204.1
unnamed: IC34.2 (X6), R204.2, R205.1
unnamed: IC34.4 (X7), R205.2
unnamed: IC35.13 (X0), R206.2, R207.1
unnamed: IC35.14 (X1), R207.2, R208.1
unnamed: IC35.15 (X2), R208.2, R209.1
unnamed: IC35.12 (X3), R209.2, R210.1
unnamed: IC30.15 (X2), IC32.3 (X)
unnamed: IC30.14 (X1), IC31.3 (X)
unnamed: IC29.3 (X), IC30.13 (X0)
unnamed: IC30.12 (X3), IC33.3 (X)
unnamed: IC30.1 (X4), IC34.3 (X)
unnamed: IC30.5 (X5), IC35.3 (X)
unnamed: IC7.3 (X), IC36.13 (X0)
unnamed: IC9.3 (X), IC36.14 (X1)
unnamed: IC16.3 (X), IC36.15 (X2)
unnamed: IC23.3 (X), IC36.12 (X3)
unnamed: IC30.3 (X), IC36.1 (X4)
