mattinmir/fyp/(commit log)

2016-12-14 detects voltages
2017-03-12 Working rod detection
2017-05-19 STL Files
    [Test_Rods.stl, UnitRod_inner.stl, UnitRod_outer.stl]
2017-05-23 new rods
    [UnitRod_Conductive.stl, UnitRod_NonConductive.stl]
2017-05-26 Circuit diagrams and 3d models
    [TenRod_Conductive.stl, TenRod_NonConductive.stl, UnitRod_Conductive.stl, fyp.sch, stripboard.fzz]
2017-05-28 New designs
    [Board_Base.stl, Split_Rod.stl, TenRod_Conductive.stl, TenRod_NonConductive.stl, Test_Rods.stl, UnitRod_Conductive.stl, UnitRod_NonConductive.stl, UnitRod_inner.stl]
2017-05-30 updated rod
    [TenRod_Conductive.stl, TenRod_NonConductive.stl, Test_Rods.stl, UnitRod_Conductive.stl, UnitRod_NonConductive.stl, UnitRod_inner.stl, UnitRod_outer.stl, fyp.sch]
2017-05-30 split rod
    [Split_Rod.stl]
2017-05-31 Renamed 'bluetooth' to avoid conflicts
    [bt.ino]
2017-05-31 Edited rod/lid
    [Split_Rod.stl]
2017-06-04 Resistor sim
    [Split_Rod.stl]
2017-06-06 updated for 3 levels of mux
    [Board_Lid.stl, Split_Rod.stl, board_lid_test.stl]
2017-06-09 final layout
    [final.fzz]
2017-06-11 updated rod size
    [board_lid_test.stl, split_rod v22.stl, stripboard.fzz]
2017-06-12 update models
    [Split_Rod.stl, board_lid_test.stl, split_rod v22.stl]
2017-06-13 header models
    [Board_Lid.stl, board_headers_test.stl, split_rod_header.stl]
2017-06-14 filled hole
    [filled_hole.stl]
2017-06-15 all rods
    [header_10_rod v2.stl, header_2_rod v2.stl, header_3_rod v2.stl, header_4_rod v2.stl, header_5_rod v2.stl, header_6_rod v2.stl, header_7_rod v2.stl, header_8_rod v2.stl]
2017-06-18 updated sizes
    [header_2_rod v2.stl, header_3_rod v2.stl, header_4_rod v2.stl, header_5_rod v2.stl, header_6_rod v2.stl, header_7_rod v2.stl, header_8_rod v2.stl, header_rod v5.stl]
2017-06-20 circuit diagram
